luccadalleprane/PROJETO-FINAL/README.md

# Controle de Posição de um Aeropêndulo com Lógica Fuzzy

**Projeto Final da disciplina de Controle Inteligente**

**Instituto Federal do Espírito Santo (IFES) – Campus Linhares**

<div align="center">
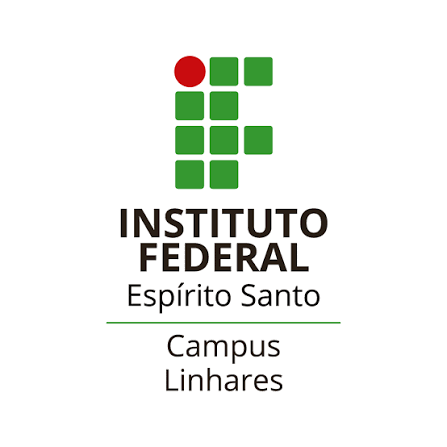
[picture p1: images/IFES.png]
  
</div>

## 📖 Sobre o Projeto

Este projeto apresenta o desenvolvimento de um sistema de controle de posição angular para um aeropêndulo utilizando Lógica Fuzzy do tipo Mamdani.

O aeropêndulo consiste em uma haste articulada acionada por um conjunto motor-hélice, caracterizado por uma dinâmica não linear e naturalmente instável. O objetivo do controlador é estabilizar a posição angular da haste e rejeitar perturbações externas, mantendo o sistema próximo ao ponto de operação desejado.

---

## 🔧 Materiais

* ESP32
* Motor Brushless DC (BLDC)
* VESC (Vedder Electronic Speed Controller) Autoro V4
* Encoder incremental para medição da posição angular 600P/R
* Bateria LiPo 3s 11,1 V 2200 mah
* Estrutura mecânica composta por peças impressas em 3D e perfis metálicos
* Motor DYS D2830 1300KV
* Hélice 9050

---

## 🧠 Estratégia de Controle

O sistema utiliza um controlador Fuzzy Mamdani com duas variáveis de entrada:

* Erro angular
* Velocidade do erro

A saída do controlador corresponde a uma correção de corrente aplicada ao motor. Além disso, foi implementada uma corrente de equilíbrio (*bias current*), responsável por manter o aeropêndulo próximo ao ponto de operação, enquanto o controlador Fuzzy realiza a compensação de perturbações e corrige desvios de posição.

A sintonia das funções de pertinência, dos singletons e da base de regras foi realizada de forma empírica e experimental, por meio de sucessivos ensaios no protótipo físico. Os parâmetros foram ajustados com base na observação da resposta dinâmica do sistema, buscando um compromisso entre estabilidade, rapidez de resposta e rejeição de perturbações.

<div align="center">
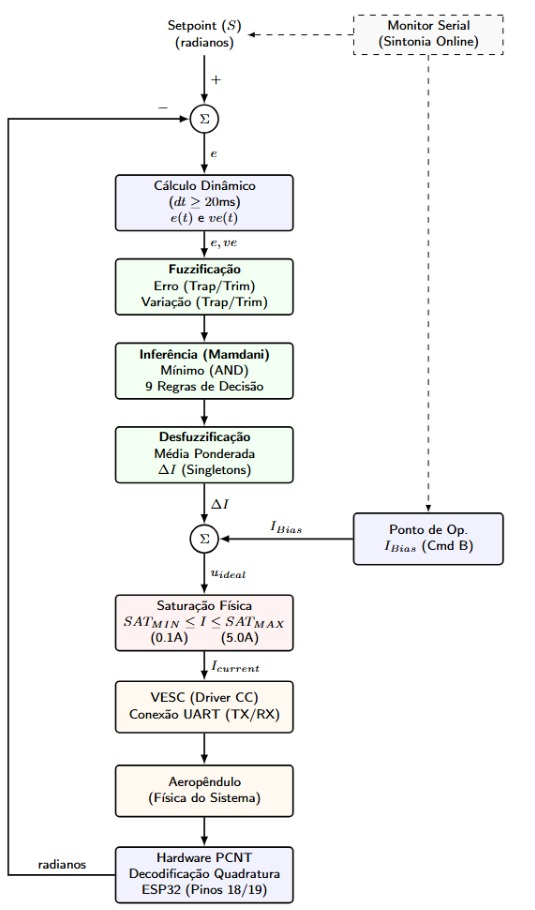
[picture p2: images/DIAGRAMA_DO_CONTROLADOR.png]
  
</div>

<p align="center">
  <em>Diagrama de blocos da malha fechada do controlador Fuzzy implementado no aeropêndulo.</em>
</p>

---

## ⚙️ Principais Características

* Controle em malha fechada com realimentação;
* Implementação embarcada em ESP32;
* Comunicação com o VESC via UART;
* Controlador Fuzzy Mamdani baseado em regras heurísticas;
* Compensação de perturbações através de corrente de equilíbrio e ação Fuzzy;
* Aplicação em um sistema não linear e instável.

---

## 🎯 Objetivos do Projeto

* Desenvolver uma plataforma experimental para estudos de controle;
* Aplicar técnicas de Lógica Fuzzy em sistemas dinâmicos reais;
* Avaliar o desempenho de estratégias de controle em um aeropêndulo;

---

## 👨‍💻 Tecnologias Utilizadas

* ESP32
* Lógica Fuzzy Mamdani
* VESC UART
* Encoder incremental
* Impressão 3D
* Controle Embarcado

---

## 📚 Contexto Acadêmico

Este trabalho foi desenvolvido como projeto final da disciplina de **Controle Inteligente** do curso de Engenharia de Controle e Automação do **Instituto Federal do Espírito Santo (IFES) – Campus Linhares**, servindo como plataforma de estudos em Sistemas Embarcados, Controle Inteligente e Lógica Fuzzy aplicada ao controle de sistemas dinâmicos.

<p align="center">
  <a href="Artigo_do_projeto.pdf">
    📄 Visualizar artigo completo
  </a>
</p>

<div align="center">
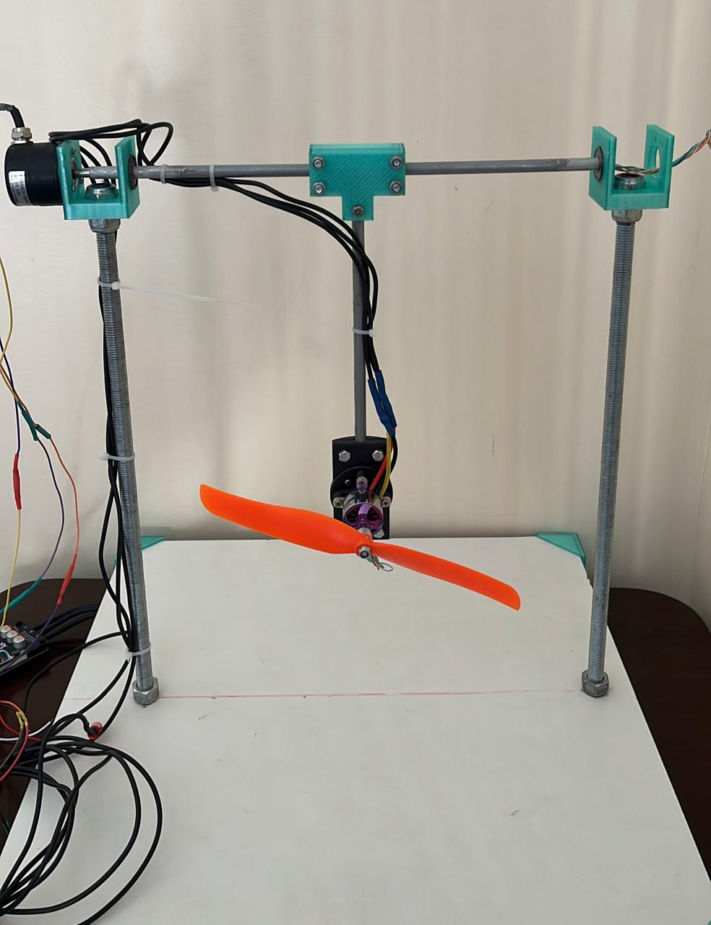
[picture p3: AEROPENDULO.png]
  
</div>

<p align="center">
  <em>Protótipo experimental do aeropêndulo desenvolvido.</em>
</p>
